Ismael034/USBnet/hardware/usbnet.kicad_pcb

## KiCad design hardware/usbnet.kicad_pcb (2026-10-16)

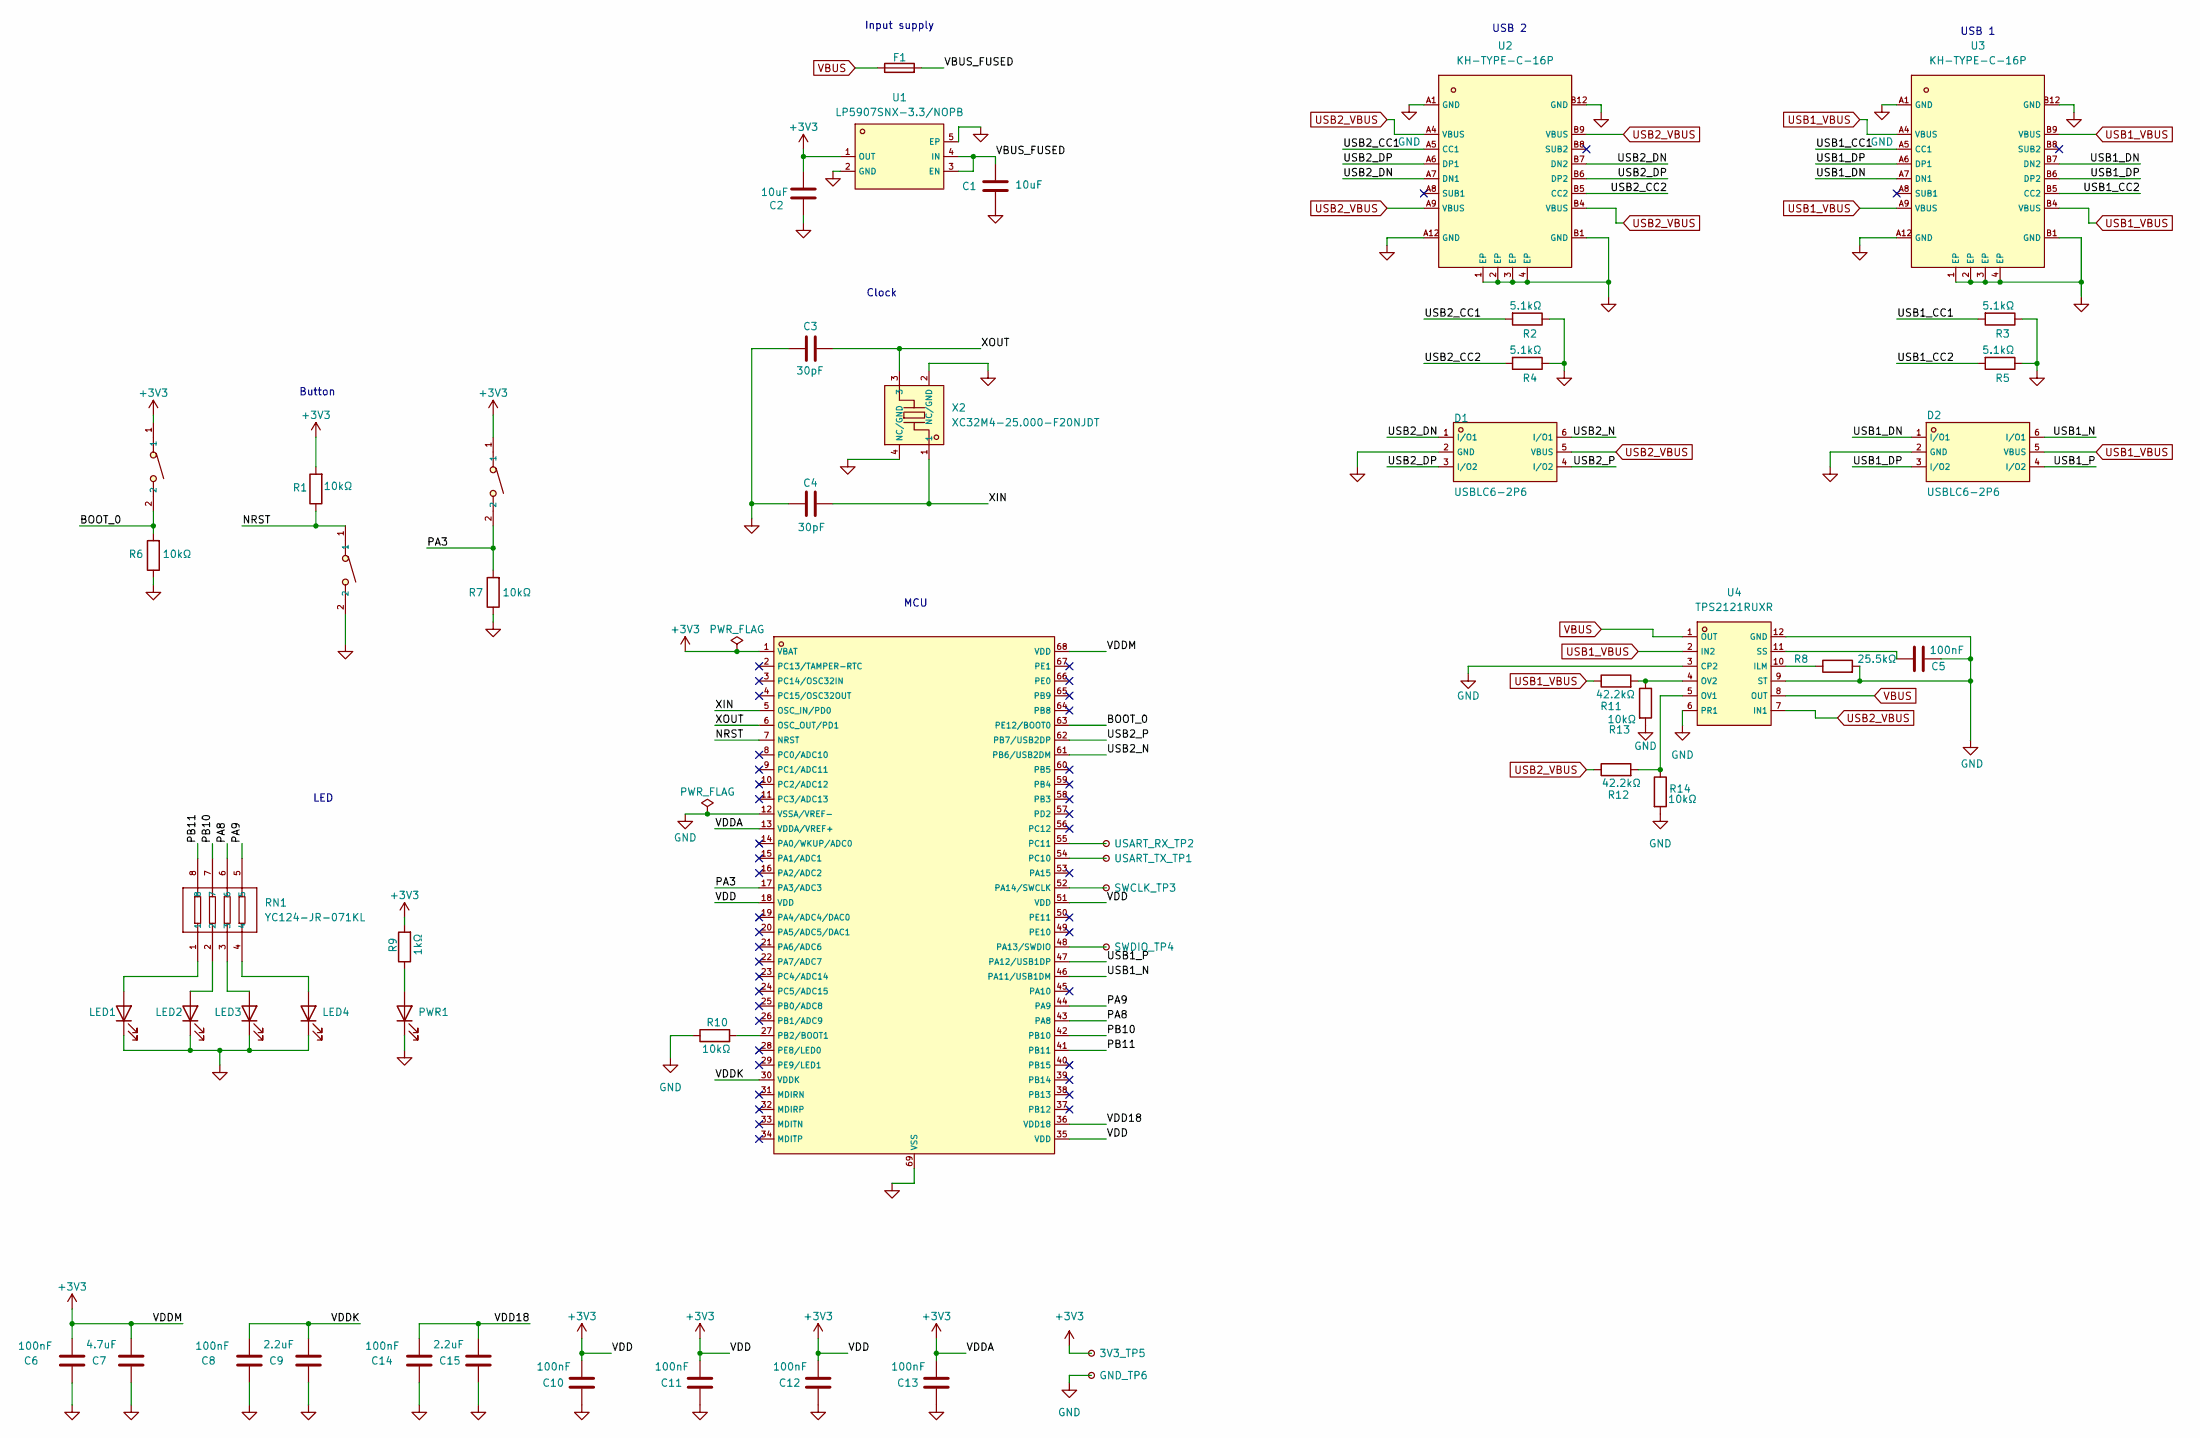
[picture p3: schematic usbnet.kicad_sch]

Parts:
3V3_TP5: TestPoint_Small; TestPoint_Pad_D1.0mm
BOOT0: TS-1088-AR02016; C720477_SW-SMD_L3_9-W3_0-P4_45; Manufacturer Part TS-1088-AR02016; LCSC Part Name 4*3*2mm 立贴 轻触开关
C1, C2: 10uF; C_0402_1005Metric; Voltage Rating 10V; Manufacturer Part CL05A106MP5NUNC; LCSC Part Name CAP CER 10uF 10V X5R 0402
C3, C4: 30pF; C_0402_1005Metric; Manufacturer Part CC0402JRNPO9BN300; LCSC Part Name 30pF ±5% 50V
C5: 100nF; C_0402_1005Metric; Manufacturer Part CL05B104KO5NNNC; LCSC Part Name 100nF ±10% 16V
C6, C8, C10, C11, C12, C13, C14: 100nF; C_0402_1005Metric; Manufacturer Part CC0402KRX7R7BB104; LCSC Part Name CAP CER 100nF 16V X7R 0402
C7: 4.7uF; C_0402_1005Metric; Manufacturer Part CL05A475KP5NRNC; LCSC Part Name CAP CER 4.7µF 10V X5R 0402
C9, C15: 2.2uF; C_0402_1005Metric; Manufacturer Part CL05A225MQ5NSNC; LCSC Part Name CAP CER 2.2µF 6.3V X5R 0402
D1, D2: USBLC6-2P6; C2827693_SOT-666-6_L1_6-W1_2-P0_50-LS1_6-BL; Manufacturer Part USBLC6-2P6; LCSC Part Name MSL=3
F1: JK-SMD0805-020-30V; Fuse_0805_2012Metric; Manufacturer Part JK-SMD0805-020-30V; LCSC Part Name 30V 200mA 0805自恢复
GND_TP6: TestPoint_Small; TestPoint_Pad_D1.0mm
LED1, LED2: XL-1608UYC-06; LED_0603_1608Metric; Manufacturer Part XL-1608UYC-06; LCSC Part Name XL-1608UYC-06
LED3: XL-1608UGC-04; LED_0603_1608Metric; Manufacturer Part XL-1608UGC-04; LCSC Part Name XL-1608UGC-04
LED4: NCD0603R1; LED_0603_1608Metric; Manufacturer Part NCD0603R1; LCSC Part Name NCD0603R1
PWR1: NCD0603R1; LED_0603_1608Metric; Manufacturer Part NCD0603R1; LCSC Part Name NCD0603R1
R1, R6, R7, R10, R13, R14: 10kΩ; R_0402_1005Metric; Manufacturer Part RC0402FR-0710KL; LCSC Part Name RES 10kΩ ±1% 62.5mW 0402
R2, R3, R4, R5: 5.1kΩ; R_0402_1005Metric; Manufacturer Part RC0402FR-075K1L; LCSC Part Name RES 5.1kΩ ±1% 62.5mW 0402
R8: 25.5kΩ; R_0402_1005Metric; Manufacturer Part RC0402FR-0725K5L; LCSC Part Name RES 25.5kΩ ±1% 62.5mW 0402
R9: 1kΩ; R_0402_1005Metric; Manufacturer Part 0402WGF1001TCE; LCSC Part Name 1kΩ ±1% 62.5mW 厚膜电阻
R11, R12: 42.2kΩ; R_0402_1005Metric; Manufacturer Part 0402WGF4222TCE; LCSC Part Name RES 42.2kΩ ±1% 62.5mW 0402
RESET1: TS-1088-AR02016; C720477_SW-SMD_L3_9-W3_0-P4_45; Manufacturer Part TS-1088-AR02016; LCSC Part Name 4*3*2mm 立贴 轻触开关
RN1: YC124-JR-071KL; C326869_RES-ARRAY-SMD_0804-8P-L2_0-W1_0-BL; LCSC C326869
SWCLK_TP3: TestPoint_Small; TestPoint_Pad_D1.0mm
SWDIO_TP4: TestPoint_Small; TestPoint_Pad_D1.0mm
U1: LP5907SNX-3.3/NOPB; C133572_ZQFN-4L_L1_0-W1_0-P0_63-BL-EP; LCSC C133572
U2, U3: KH-TYPE-C-16P; C709357_USB-C-SMD_KH-TYPE-C-16P; LCSC C709357
U4: TPS2121RUXR; C485916_VQFN-HR-12_L2_5-W2_0-P0_50-BL; LCSC C485916
U5: CH32V467WEU6; C55778389_QFN-68_L8_0-W8_0-P0_40-TL-EP5_5; LCSC C55778389
USART_RX_TP2: TestPoint_Small; TestPoint_Pad_D1.0mm
USART_TX_TP1: TestPoint_Small; TestPoint_Pad_D1.0mm
USER1: TS-1088-AR02016; C720477_SW-SMD_L3_9-W3_0-P4_45; Manufacturer Part TS-1088-AR02016; LCSC Part Name 4*3*2mm 立贴 轻触开关
X2: XC32M4-25.000-F20NJDT; C2842189_CRYSTAL-SMD_4P-L3_2-W2_5-BL; LCSC C2842189

Connections:
+3V3: 3V3_TP5.1, BOOT0.1, C2.2, C6.2, C7.2, C10.2, C11.2, C12.2, C13.2, R1.2, R9.2, U1.1 (OUT), U5.1 (VBAT), U5.13 (VDDA/VREF+), U5.18 (VDD), U5.35 (VDD), U5.51 (VDD), U5.68 (VDD), USER1.1; also elsewhere on the board
/BOOT_0: BOOT0.2, R6.2, U5.63 (PE12/BOOT0)
/NRST: R1.1, RESET1.1, U5.7 (NRST)
/PA3: R7.2, U5.17 (PA3/ADC3), USER1.2
/PA8: RN1.6, U5.43 (PA8)
/PA9: RN1.5, U5.44 (PA9)
/PB10: RN1.7, U5.42 (PB10)
/PB11: RN1.8, U5.41 (PB11)
/USB1_CC1: R3.2, U3.A5 (CC1)
/USB1_CC2: R5.2, U3.B5 (CC2)
/USB1_DN: D2.1 (I/O1), U3.A7 (DN1), U3.B7 (DN2)
/USB1_DP: D2.3 (I/O2), U3.A6 (DP1), U3.B6 (DP2)
/USB1_N: D2.6 (I/O1), U5.46 (PA11/USB1DM)
/USB1_P: D2.4 (I/O2), U5.47 (PA12/USB1DP)
/USB2_CC1: R2.2, U2.A5 (CC1)
/USB2_CC2: R4.2, U2.B5 (CC2)
/USB2_DN: D1.1 (I/O1), U2.A7 (DN1), U2.B7 (DN2)
/USB2_DP: D1.3 (I/O2), U2.A6 (DP1), U2.B6 (DP2)
/USB2_N: D1.6 (I/O1), U5.61 (PB6/USB2DM)
/USB2_P: D1.4 (I/O2), U5.62 (PB7/USB2DP)
/VBUS_FUSED: C1.2, F1.2, U1.3 (EN), U1.4 (IN)
/VDD18: C14.2, C15.2, U5.36 (VDD18)
/VDDK: C8.2, C9.2, U5.30 (VDDK)
/XIN: C4.2, U5.5 (OSC_IN/PD0), X2.1
/XOUT: C3.1, U5.6 (OSC_OUT/PD1), X2.3
GND: C1.1, C2.1, C3.2, C4.1, C5.2, C6.1, C7.1, C8.1, C9.1, C10.1, C11.1, C12.1, C13.1, C14.1, C15.1, D1.2 (GND), D2.2 (GND), GND_TP6.1, LED1.1 (K), LED2.1 (K), LED3.1 (K), LED4.1 (K), PWR1.1 (K), R2.1, R3.1, R4.1, R5.1, R6.1, R7.1, R8.2, R10.1, R13.2, R14.2, RESET1.2, U1.2 (GND), U1.5 (EP), U2.1 (EP), U2.2 (EP), U2.3 (EP), U2.4 (EP), U2.A1 (GND), U2.A12 (GND), U2.B1 (GND), U2.B12 (GND), U3.1 (EP), U3.2 (EP), U3.3 (EP), U3.4 (EP), U3.A1 (GND), U3.A12 (GND), U3.B1 (GND), U3.B12 (GND), U4.3 (CP2), U4.6 (PR1), U4.9 (ST), U4.12 (GND), U5.12 (VSSA/VREF-), U5.69 (VSS), X2.2 (NC/GND), X2.4 (NC/GND); also elsewhere on the board
unnamed: LED1.2 (A), RN1.1
unnamed: LED2.2 (A), RN1.2
unnamed: LED3.2 (A), RN1.3
unnamed: LED4.2 (A), RN1.4
unnamed: PWR1.2 (A), R9.1
unnamed: R8.1, U4.10 (ILM)
unnamed: R12.2, R14.1, U4.5 (OV1)
unnamed: R11.2, R13.1, U4.4 (OV2)
unnamed: C5.1, U4.11 (SS)
unnamed: SWDIO_TP4.1 (1_1), U5.48 (PA13/SWDIO)
unnamed: SWCLK_TP3.1 (1_1), U5.52 (PA14/SWCLK)
unnamed: R10.2, U5.27 (PB2/BOOT1)
unnamed: U5.54 (PC10), USART_TX_TP1.1 (1_1)
unnamed: U5.55 (PC11), USART_RX_TP2.1 (1_1)
USB1_VBUS: D2.5 (VBUS), R11.1, U3.A4 (VBUS), U3.A9 (VBUS), U3.B4 (VBUS), U3.B9 (VBUS), U4.2 (IN2)
USB2_VBUS: D1.5 (VBUS), R12.1, U2.A4 (VBUS), U2.A9 (VBUS), U2.B4 (VBUS), U2.B9 (VBUS), U4.7 (IN1)
VBUS: F1.1, U4.1 (OUT), U4.8 (OUT)

Notes on the sheet:
Clock
Button
Input supply
USB 2
USB 1
LED
MCU

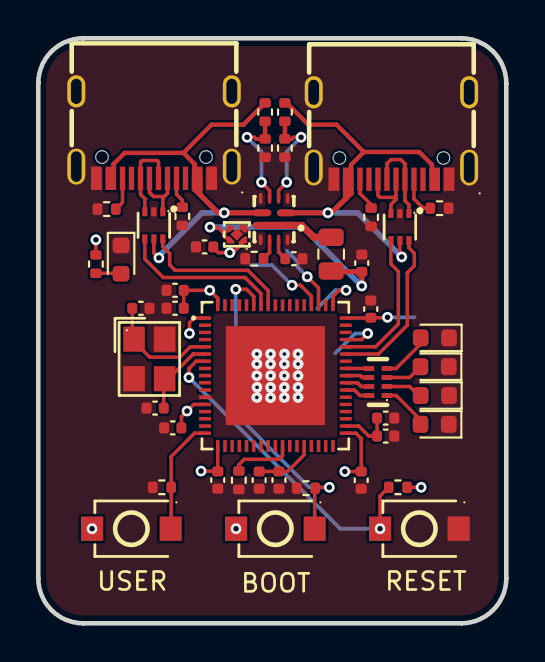
[picture p4: board usbnet.kicad_pcb from above]

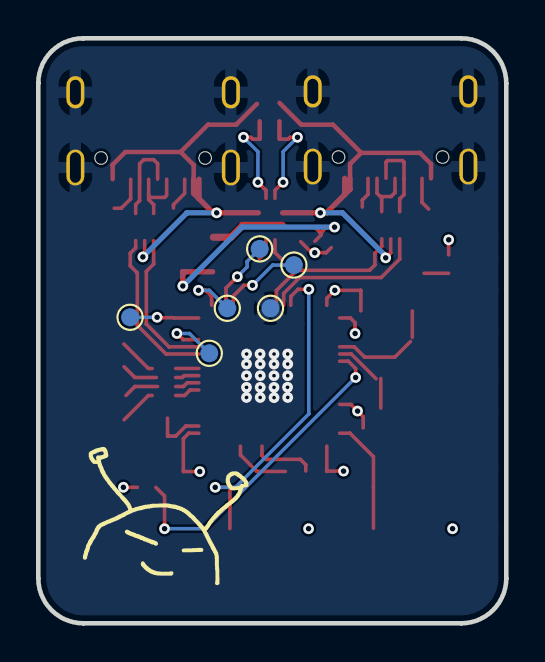
[picture p5: board usbnet.kicad_pcb from below]

Board: 4 copper layers, 26.0 x 32.5 mm, 53 parts (6 on the bottom side), 43 nets.

Other parts of the board:
SWDIO_TP5, SWDIO_TP6: TestPoint_Small; TestPoint_Pad_D1.0mm

Their connections:
+3V3: SWDIO_TP5.1 (1_1); also elsewhere on the board
GND: SWDIO_TP6.1 (1_1); also elsewhere on the board
